timethy96/WALL-E/interface/html/img/mov.png

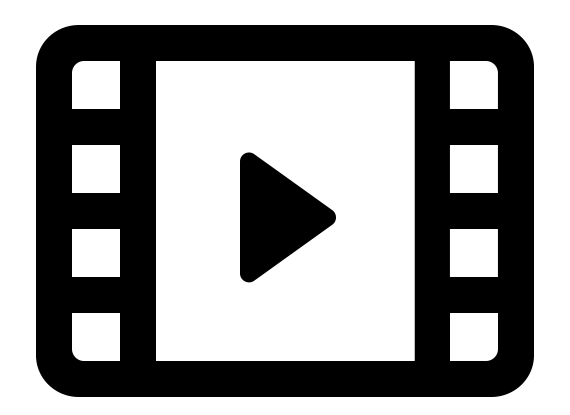
interface/html/img/mov.png
